bithuanglq/Energy_Saving_Beacon_Vehicle/README.md

# Energy_Saving_Beacon_Vehicle
*2021年第十六届恩智浦杯（原飞思卡尔智能车赛）——节能信标组国二作品（单片机代码+电路设计）*

### [大赛官网](http://smartcar.moocollege.com/home)

### CPU
英飞凌TC264双核（主控），英飞凌TC212（恒定功率充电控制）
