bithuanglq/Energy_Saving_Beacon_Vehicle/(list of files, drawings)

Other design files:
Scheme/Hardware/Bridge.SchDoc
Scheme/Hardware/C-POWER.PcbDoc
Scheme/Hardware/SR-26424.SchDoc
Scheme/Hardware/单片机.SchDoc
