bithuanglq/Energy_Saving_Beacon_Vehicle/Scheme/Software/MainControl/Seekfree_TC264_Opensource_Library/CODE/MotorCtrl.c

/*******************************************************
 电机控制函数文件
 ver1.0-2021.4.8
 ver2.0-2021.5.25 HT-S-3505
 ver3.0-2021.6.15 HT-S-3505
 *******************************************************/

/******************************************************************************/
/*-------------------------- 注意！！！！！！--------------------------------------------------*/
//如果发给同一电机的两条指令之间不加延时，电机会丢帧，来不及响应第二条指令21.4.8


#include "MotorCtrl.h"
#include "zf_gpio.h"
#include "zf_stm_systick.h"

//-------------------------------------------------------------------------------------------------------------------
//  @brief  向电机发送控制字，电机停止工作
//  @return     void
//  @note
//-------------------------------------------------------------------------------------------------------------------
void MotorStop()
{
    //控制字：报头3E，包序号，ID，命令码，数据长度（0），校验位
    //左轮ID为01，右轮ID02
    uint8 ctrl_code_l[7] = {0x3E, 0x01, 0x01, 0x50, 0x00, 0x00, 0x00};
    uint8 ctrl_code_r[7] = {0x3E, 0x02, 0x02, 0x50, 0x00, 0x00, 0x00};
    N_CRC16(ctrl_code_l,5);
    N_CRC16(ctrl_code_r,5);
    uart_putbuff(uart_motor, ctrl_code_l, 7);
    systick_delay_us(STM0, 1000);
    uart_putbuff(uart_motor, ctrl_code_r, 7);
    systick_delay_us(STM0, 1000);
}

//-----------------------------------------------------------------------------------------------------------------
//  @brief      角速度环，电机转速PD调节
//  @param      n_c            //给定小车质心的速度（未知量纲转速，取值-1,000,000~+1,000,000，测试建议取值300,000），即左右轮平均值，正值表示headflag = 0，负值headflag = 1
//  @param      bias           //摄像头图像得到的信标灯与中心位置的偏差，左侧为负数，此值最好归一化
//  @return     void
//  @note       得到的n_l,n_r正值表示向前，负值表示向后转，注意两轮对称放置若输入同一控制字则旋转方向相反
//               n_l表示01号电机转速，n_r表示02号电机转速
//-------------------------------------------------------------------------------------------------------------------
extern sint16 omiga_c = 0;

void AngularVelocityLoop(sint16 n_c, sint16 bias)
{
    static sint16 last_bias;//角速度环控制里储存上一次偏差
    sint32 KP,KD;

    if(n_c > 8100)
    {
        KP = 30;
        KD = 30;
    }
    else if(n_c > 3000)
    {
        KP = 20;
        KD = 20;
    }
    else
    {
        KP = 10;
        KD = 10;
    }
    omiga_c = ((sint16)KP*bias + (sint16)KD*(bias - last_bias)) ;
    //限幅        应该对omiga_c 限幅           ！！！！！
    if(omiga_c > max)omiga_c = max;
    else if(omiga_c < min)omiga_c = min;      //参数可改

    last_bias = bias;
}

//-------------------------------------------------------------------------------------------------------------------
//  @brief  向电机发送控制字，控制左右轮转速；本函数被角速度环调用以调速
//  @param  n_l,n_r 左右轮转速
//  @param
//  @return     void
//  @note   转速量纲0.1rpm
//-------------------------------------------------------------------------------------------------------------------
void SendSpeedCtrlCode(sint16 n_l,sint16 n_r)
{
    //控制字：报头3E，包序号（分辨从机应答），设备地址码，命令码，数据长度，数据（小端，低->高），校验位（两位，小端）
    //左轮ID为01，右轮ID02
    uint8 ctrl_code_l[9] = {0x3E, 0x01, 0x01, 0x54, 0x02, 0x00, 0x00, 0x00, 0x00};
    uint8 ctrl_code_r[9] = {0x3E, 0x02, 0x02, 0x54, 0x02, 0x00, 0x00, 0x00, 0x00};

    n_l =-n_l;//两电机方向相反,l电机在headflag = 0 默认向后转，需要取反使其向前转，与r电机一致
    ctrl_code_l[5] = (uint8)(n_l & 0x00FF);
    ctrl_code_l[6] = (uint8)((n_l & 0xFF00)>>8);

    ctrl_code_r[5] = (uint8)(n_r & 0x00FF);
    ctrl_code_r[6] = (uint8)((n_r & 0xFF00)>>8);

    N_CRC16(ctrl_code_l,7);
    N_CRC16(ctrl_code_r,7);

    uart_putbuff(uart_motor, ctrl_code_l, 9);
    systick_delay_us(STM0, 1000);
    uart_putbuff(uart_motor, ctrl_code_r, 9);
    systick_delay_us(STM0, 1000);
}

//-------------------------------------------------------------------------------------------------------------------
//  @brief  原地旋转
//  @param  n 左右轮转速 正值逆时针，负值顺时针
//  @return     void
//  @note   转速量纲未知
//-------------------------------------------------------------------------------------------------------------------
void Circling(sint16 n)
{

    SendSpeedCtrlCode(n,-n);
}



//-------------------------------------------------------------------------------------------------------------------
//  @brief  增量式电机转角控制
//  @param  angle_inc角度增量，9000表示90°，36000表示360°，以此类推，作者在.h定义了一些宏，以便调试；max_spd最大速度，注意为无符号32位
//  @return     void
//  @note
//测试用例：
//IncrementAngleCtrl(deg_5,deg_30);
//gpio_toggle(P20_8);
//systick_delay_ms(STM0, 50);
//-------------------------------------------------------------------------------------------------------------------
void IncrementAngleCtrl(sint16 angle_inc_l, sint16 angle_inc_r )
{

    uint8 code_l[9] = { 0x3E, 0x01, 0x01, 0x56, 0x02, 0x00, 0x00, 0x00, 0x00 } ;
    uint8 code_r[9] = { 0x3E, 0x02, 0x02, 0x56, 0x02, 0x00, 0x00, 0x00, 0x00 } ;

    angle_inc_l = -angle_inc_l;
    code_l[5] = (uint8)(angle_inc_l & 0x00FF);
    code_l[6] = (uint8)((angle_inc_l & 0xFF00)>>8);

    code_r[5] = (uint8)(angle_inc_r & 0x000000FF);
    code_r[6] = (uint8)((angle_inc_r & 0x0000FF00)>>8);

    N_CRC16(code_l,7);
    N_CRC16(code_r,7);

    uart_putbuff(uart_motor, code_l, 9);
    systick_delay_us(STM0, 1000);
    uart_putbuff(uart_motor, code_r, 9);
    systick_delay_us(STM0, 1000);
}

//-------------------------------------------------------------------------------------------------------------------
//  @brief  写电机参数至电机RAM
//  @param
//          [5]设备地址 ID = 0x01或 0x02
//          [6]电流阈值 I_threshold = 阈值（A）/0.03
//          [7]电压阈值 U_threshold = 阈值（V）/0.2
//          [8]RS485波特率  Boderate485 = 0（表示115200）
//          [9:12]增量式角度环angle_Kp float
//          [13:16]增量式角度环速度angle_speed float
//          [17:20]速度环比例项speed_Kp float
//          [21:24]速度环积分项speed_Ki float
//          [29]速度滤波系数 Kf = val*100
//          [30]电机功率百分比P = 1~100默认92
//  @return     void
//  @note
//-------------------------------------------------------------------------------------------------------------------
void SetMotorPID(uint8 I_threshold,uint8 U_threshold,
        float32 angle_Kp,float32 angle_speed,
        float32 speed_Kp,float32 speed_Ki)
{
    //是若将命令码0x0D改为 0x0E 为写至ROM掉电不丢失
    uint8 code_l[33] = { 0x3E, 0x01, 0x01, 0x0D, 0x1A, 0x01 } ;
    uint8 code_r[33] = { 0x3E, 0x01, 0x02, 0x0D, 0x1A, 0x02 } ;
    uint8 Boderate485 = 0;
    uint8 Kf = 0;
    uint8 P = 92;
    code_l[6] = I_threshold;
    code_r[6] = I_threshold;
    code_l[7] = U_threshold;
    code_r[7] = U_threshold;
    code_l[8] = Boderate485;
    code_r[8] = Boderate485;
    float2uint8(&code_l[9],angle_Kp);
    float2uint8(&code_r[9],angle_Kp);
    float2uint8(&code_l[13],angle_speed);
    float2uint8(&code_r[13],angle_speed);
    float2uint8(&code_l[17],speed_Kp);
    float2uint8(&code_r[17],speed_Kp);
    float2uint8(&code_l[21],speed_Ki);
    float2uint8(&code_r[21],speed_Ki);
    code_l[29] = Kf;
    code_r[29] = Kf;
    code_l[30] = P;
    code_r[30] = P;
    N_CRC16(code_l,31);
    N_CRC16(code_r,31);
    uart_putbuff(uart_motor, code_l, 33);
    systick_delay_us(STM0, 1000);
    uart_putbuff(uart_motor, code_r, 33);
    systick_delay_us(STM0, 1000);
}
void float2uint8(uint8 *buf,float32 data)
{
    uint8 *p = (uint8*)&data + 3;
    buf[0] = *(p-3);
    buf[1] = *(p-2);
    buf[2] = *(p-1);
    buf[3] = *p;
}


//CRC16校验表格
uint8 auchCRCHi[]=
{
0x00, 0xC1, 0x81, 0x40, 0x01, 0xC0, 0x80, 0x41, 0x01, 0xC0, 0x80, 0x41, 0x00, 0xC1, 0x81,
0x40, 0x01, 0xC0, 0x80, 0x41, 0x00, 0xC1, 0x81, 0x40, 0x00, 0xC1, 0x81, 0x40, 0x01, 0xC0,
0x80, 0x41, 0x01, 0xC0, 0x80, 0x41, 0x00, 0xC1, 0x81, 0x40, 0x00, 0xC1, 0x81, 0x40, 0x01,
0xC0, 0x80, 0x41, 0x00, 0xC1, 0x81, 0x40, 0x01, 0xC0, 0x80, 0x41, 0x01, 0xC0, 0x80, 0x41,
0x00, 0xC1, 0x81, 0x40, 0x01, 0xC0, 0x80, 0x41, 0x00, 0xC1, 0x81, 0x40, 0x00, 0xC1, 0x81,
0x40, 0x01, 0xC0, 0x80, 0x41, 0x00, 0xC1, 0x81, 0x40, 0x01, 0xC0, 0x80, 0x41, 0x01, 0xC0,
0x80, 0x41, 0x00, 0xC1, 0x81, 0x40, 0x00, 0xC1, 0x81, 0x40, 0x01, 0xC0, 0x80, 0x41, 0x01,
0xC0, 0x80, 0x41, 0x00, 0xC1, 0x81, 0x40, 0x01, 0xC0, 0x80, 0x41, 0x00, 0xC1, 0x81, 0x40,
0x00, 0xC1, 0x81, 0x40, 0x01, 0xC0, 0x80, 0x41, 0x01, 0xC0, 0x80, 0x41, 0x00, 0xC1, 0x81,
0x40, 0x00, 0xC1, 0x81, 0x40, 0x01, 0xC0, 0x80, 0x41, 0x00, 0xC1, 0x81, 0x40, 0x01, 0xC0,
0x80, 0x41, 0x01, 0xC0, 0x80, 0x41, 0x00, 0xC1, 0x81, 0x40, 0x00, 0xC1, 0x81, 0x40, 0x01,
0xC0, 0x80, 0x41, 0x01, 0xC0, 0x80, 0x41, 0x00, 0xC1, 0x81, 0x40, 0x01, 0xC0, 0x80, 0x41,
0x00, 0xC1, 0x81, 0x40, 0x00, 0xC1, 0x81, 0x40, 0x01, 0xC0, 0x80, 0x41, 0x00, 0xC1, 0x81,
0x40, 0x01, 0xC0, 0x80, 0x41, 0x01, 0xC0, 0x80, 0x41, 0x00, 0xC1, 0x81, 0x40, 0x01, 0xC0,
0x80, 0x41, 0x00, 0xC1, 0x81, 0x40, 0x00, 0xC1, 0x81, 0x40, 0x01, 0xC0, 0x80, 0x41, 0x01,
0xC0, 0x80, 0x41, 0x00, 0xC1, 0x81, 0x40, 0x00, 0xC1, 0x81, 0x40, 0x01, 0xC0, 0x80, 0x41,
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
        judgecounter=0;
    }

    //距离速度模式转换条件判断
    if(mode_dis == 0 &&
            ((dis_v - ramp_v < 0 && camera_change==0) ||
            (dis_v - ramp_v > 0 && camera_change==1)))
        mode_dis = 1;

    AngularVelocityLoop(ramp_v,beacon_bias);//用角速度做导引
}


/////////滑动平均滤波///////////////
#define FILTER_N_Motor 20//30
sint16 MovingAverageFilter(sint16 target_v)
{
    uint8 i;
    static sint32 maFilter_sum = 0;
    static sint16 maFilter_buff[FILTER_N_Motor] = {0};
    static sint16 last_target_v;

    if(last_target_v*target_v<0 || mode_dis==1)
    {
        for(i = 0; i < FILTER_N_Motor ; i++)
            maFilter_buff[i] = 0; // 所有数据清空，防止车后退
        maFilter_sum = 0;
    }

    maFilter_sum -= maFilter_buff[0];
    for(i = 0; i < FILTER_N_Motor-1 ; i++)
        maFilter_buff[i] = maFilter_buff[i + 1]; // 所有数据左移，低位扔掉
    maFilter_buff[FILTER_N_Motor-1] = target_v;
    maFilter_sum += maFilter_buff[FILTER_N_Motor-1];


    last_target_v = target_v;
    return (sint16)(maFilter_sum/(sint16)FILTER_N_Motor);
}

/////////加权递推滤波///////////////
sint16 WeightedRecursionFilter(sint16 target_v)
{
    uint8 i;

    sint32 wrFilter_sum = 0;
    static sint16 wrFilter_buff[FILTER_N_Motor + 1] = {0};
    wrFilter_buff[FILTER_N_Motor] = target_v;
    for(i=0;i<FILTER_N_Motor;i++)
    {
        wrFilter_buff[i]=wrFilter_buff[i+1];
        wrFilter_sum += wrFilter_buff[i]*(i+1);
    }
    return (sint16)(wrFilter_sum / (sint16)(( FILTER_N_Motor*(FILTER_N_Motor+1) )>>1 ));
}

//陀螺仪速度反馈阻尼回路
void GyroscopeDampingLoop(sint16 omiga_c)
{

     get_icm20602_gyro_spi();

     sint16 bias = omiga_c + (sint16)icm_gyro_z;     //负负得正
     static sint16 last_bias = 0;

     sint16 omiga_loop = omiga_c;
     omiga_loop = omiga_c + bias ;

     //限幅

     //执行
     sint16 n_l,n_r;
     n_l = ramp_v + omiga_loop;
     n_r = ramp_v - omiga_loop;


     SendSpeedCtrlCode(n_l,n_r);

     last_bias = bias;
 }
