bithuanglq/Energy_Saving_Beacon_Vehicle/(notices)

Notices in the files:
Scheme/Software/ConstantPower/Seekfree_TC212_Opensource_Library/USER/TC212_config.h:
Copyright (c) 2020,Öð·É¿Æ¼¼
All rights reserved.
